jpskenn/STMeishi/README.md

# STMeishi
STM32F303CCT6 based evaluation keyboard in Meishi (= name card).

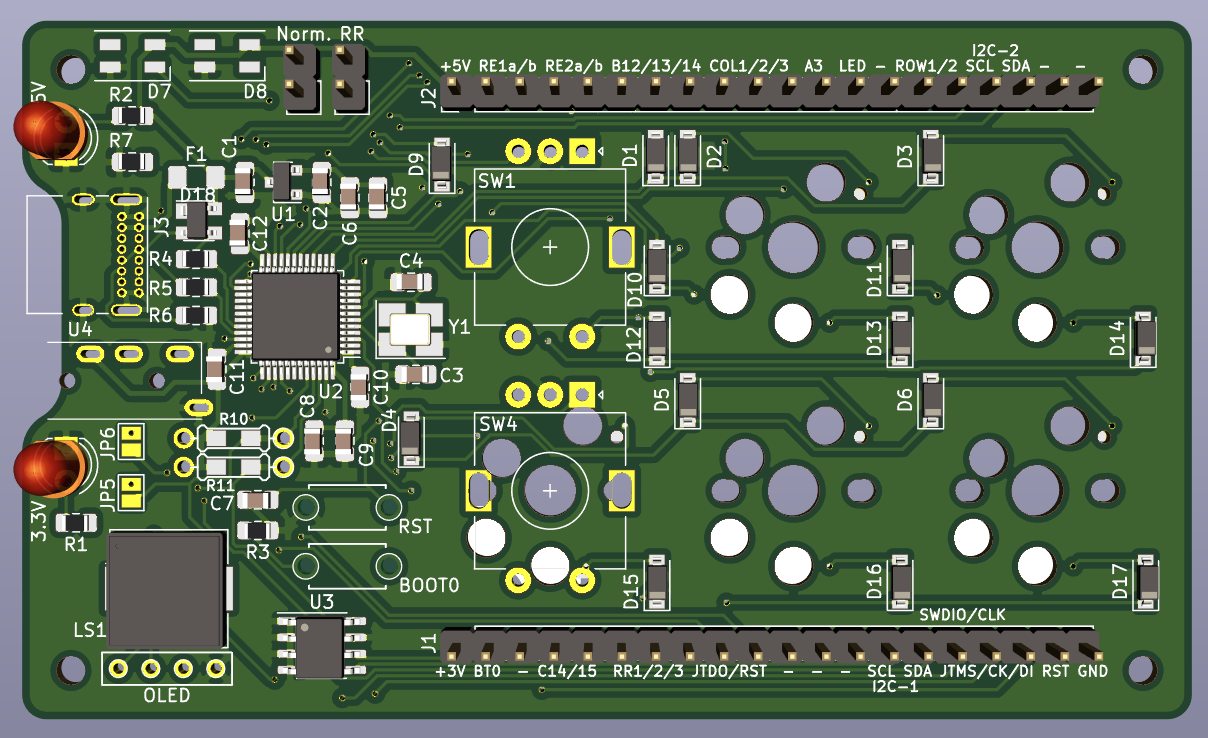
[picture p1: assets/STMeishi_v.1_3dModel_front.png]
STMeishi v.1 3D model front


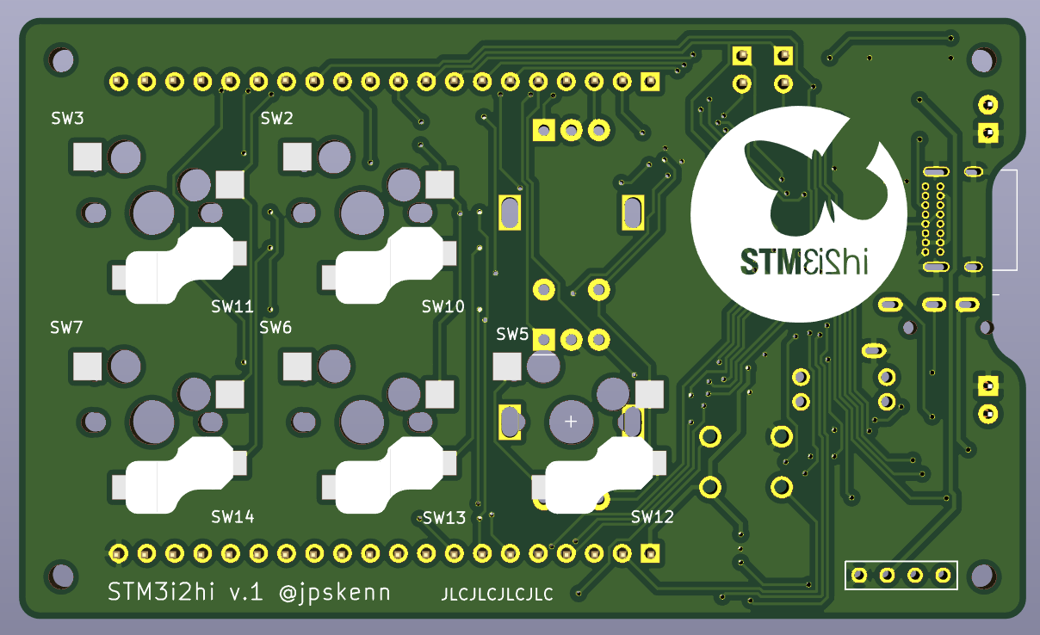
[picture p2: assets/STMeishi_v.1_3dModel_back.png]
STMeishi v.1 3D model back
