jpskenn/STMeishi/PCB/meishi_stm32.kicad_pcb

## KiCad design PCB/meishi_stm32.kicad_pcb (2020-10-25)

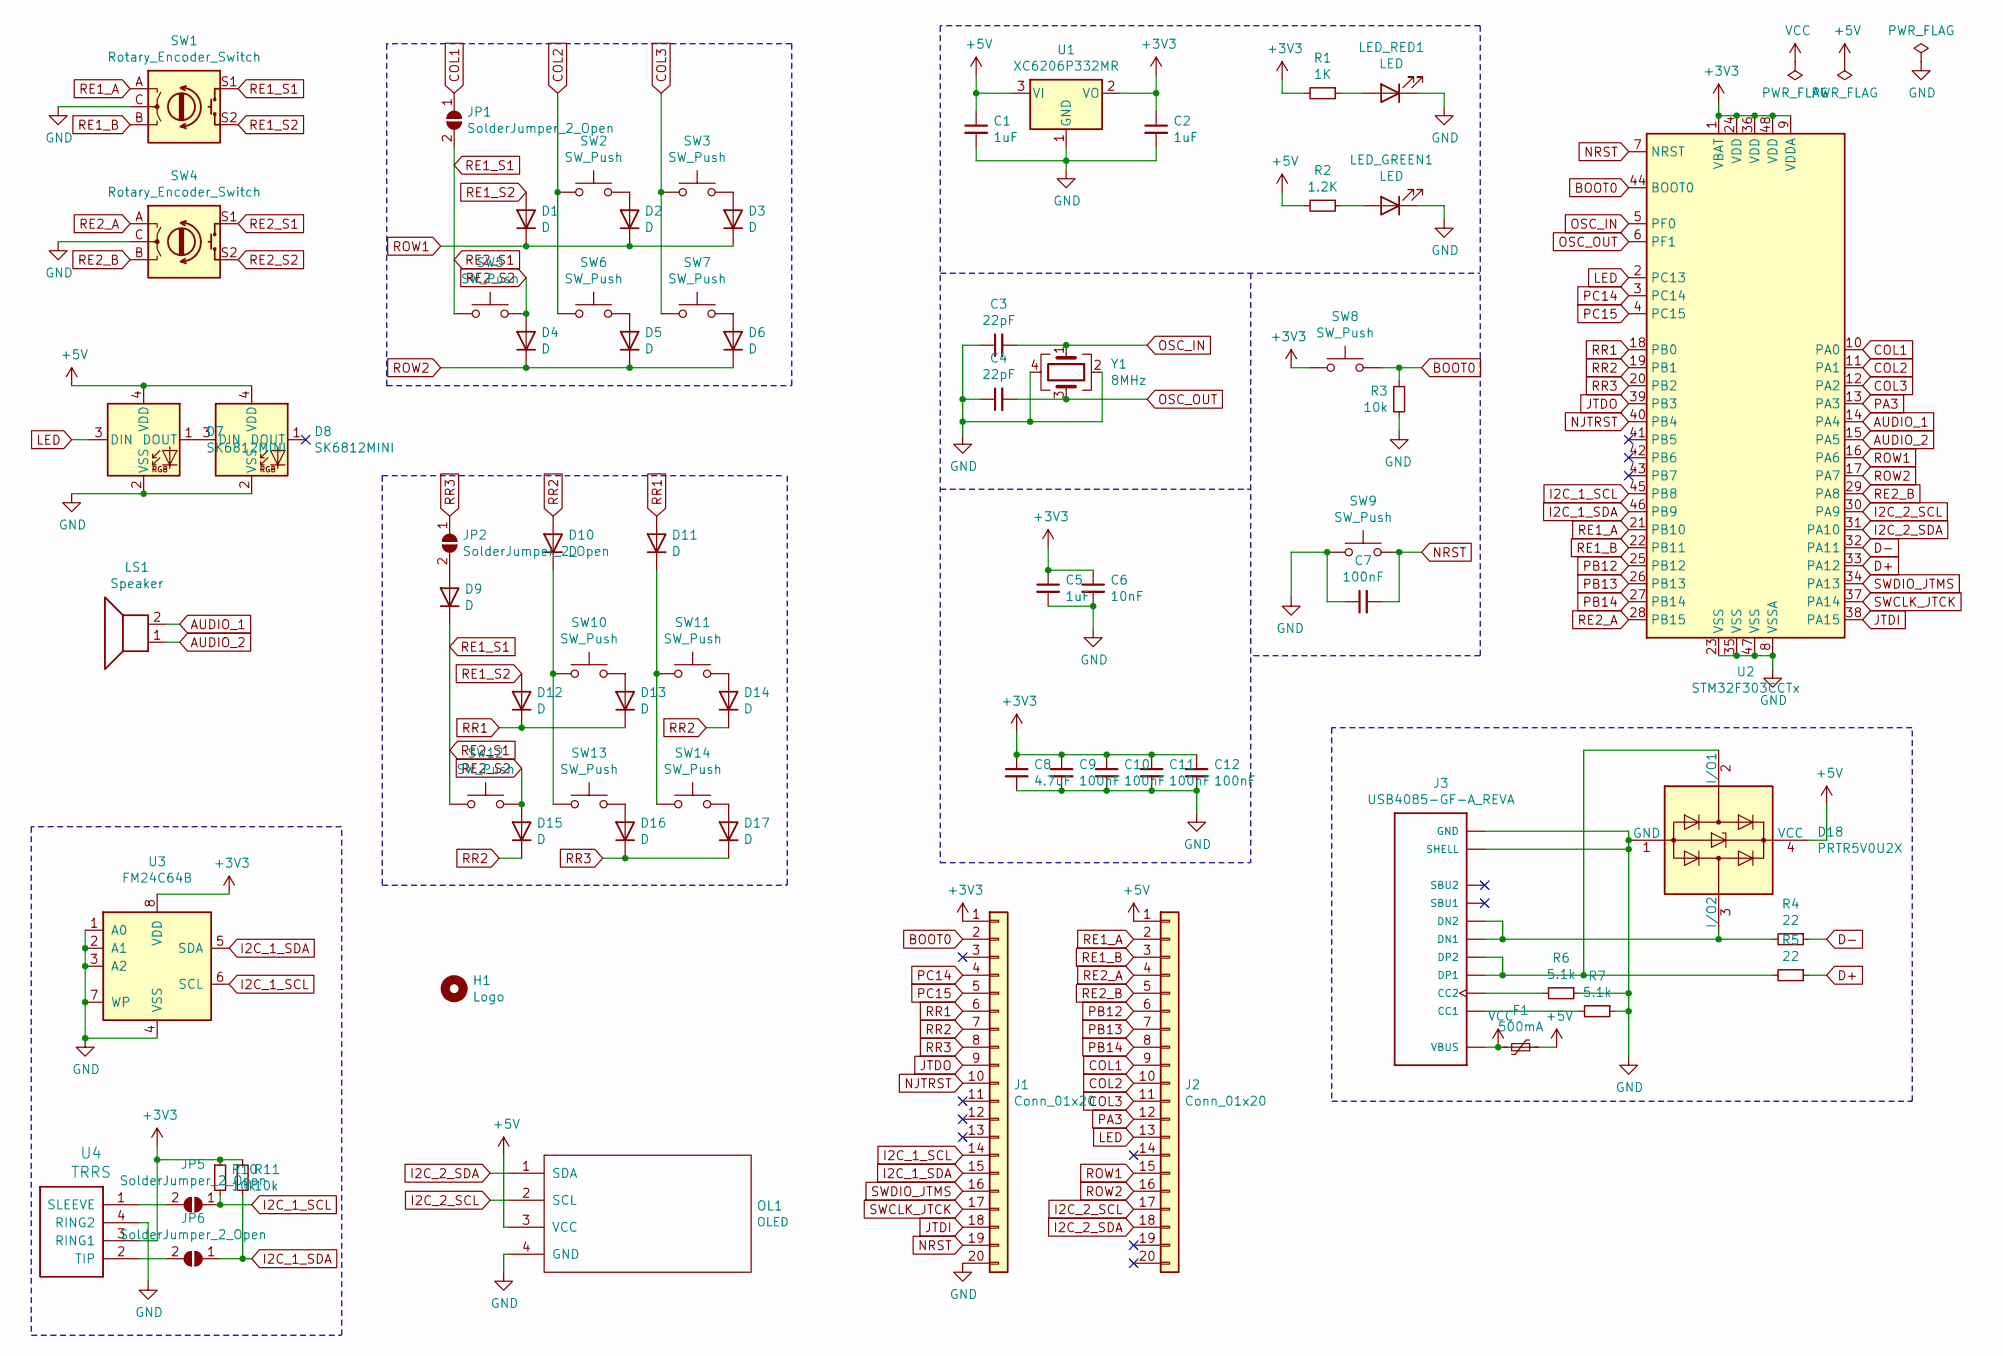
[picture p3: schematic meishi_stm32.sch]

Parts:
C1, C2, C5: 1uF; C_0805_2012Metric_Pad1.15x1.40mm_HandSolder; LCSC Part # C28323
C3, C4: 22pF; C_0805_2012Metric_Pad1.15x1.40mm_HandSolder; LCSC Part # C1804
C6: 10nF; C_0805_2012Metric_Pad1.15x1.40mm_HandSolder; LCSC Part # C15850
C7, C9, C10, C11, C12: 100nF; C_0805_2012Metric_Pad1.15x1.40mm_HandSolder; LCSC Part # C49678
C8: 4.7uF; C_0805_2012Metric_Pad1.15x1.40mm_HandSolder; LCSC Part # C1779
D1, D2, D3, D4, D5, D6, D9, D10, D11, D12, D13, D14, D15, D16, D17: D; D_SOD-123; LCSC Part # C81598
D7, D8: SK6812MINI; LED_SK6812MINI_PLCC4_3.5x3.5mm_P1.75mm
D18: PRTR5V0U2X; SOT-143; LCSC Part # C78442
F1: 500mA; Fuse_1206_3216Metric_Pad1.42x1.75mm_HandSolder; LCSC Part # C70076
H1: Logo; st_meishi_logo_475dpi
J1, J2: Conn_01x20; PinHeader_1x20_P2.54mm_Vertical
J3: USB4085-GF-A_REVA; USB_C_Receptacle_GCT_USB4085_pad_modified
JP1, JP2: SolderJumper_2_Open; PinHeader_1x02_P2.54mm_Vertical
JP5, JP6: SolderJumper_2_Open; SolderJumper-2_P1.3mm_Open_Pad1.0x1.5mm
LED_GREEN1: LED; LED_D4.0mm
LED_RED1: LED; LED_D4.0mm
LS1: Speaker; Buzzer_Murata_PKMCS0909E4000-R1
OL1: OLED
R1: 1K; R_0805_2012Metric_Pad1.15x1.40mm_HandSolder; LCSC Part # C17513
R2: 1.2K; R_0805_2012Metric_Pad1.15x1.40mm_HandSolder; LCSC Part # C17379
R3: 10k; R_0805_2012Metric_Pad1.15x1.40mm_HandSolder; LCSC Part # C17414
R4, R5: 22; R_0805_2012Metric_Pad1.15x1.40mm_HandSolder; LCSC Part # C17561
R6, R7: 5.1k; R_0805_2012Metric_Pad1.15x1.40mm_HandSolder; LCSC Part # C27834
R10, R11: 10k; Resistor-Hybrid-Front; LCSC Part # C17414
SW1, SW4: Rotary_Encoder_Switch; RotaryEncoder_Alps_EC11E-Switch_Vertical_H20mm
SW2, SW3, SW5, SW6, SW7: SW_Push; MXOnly-1U-Hotswap
SW8, SW9: SW_Push; ResetSW_1side
SW10, SW11, SW12, SW13, SW14: SW_Push; Choc_Hotswap_single_side
U1: XC6206P332MR; SOT-23; LCSC Part # C5446
U2: STM32F303CCTx; LQFP-48_7x7mm_P0.5mm; LCSC Part # C81523
U3: FM24C64B; SOIC-8_3.9x4.9mm_P1.27mm; LCSC Part # C79988
U4: TRRS; CON_MJ-4PP-9
Y1: 8MHz; Crystal_SMD_3225-4Pin_3.2x2.5mm_HandSoldering; LCSC Part # C57131

Connections:
+3V3: C2.1, C5.1, C6.1, C8.1, C9.1, C10.1, C11.1, C12.1, J1.1, R1.2, R10.1, R11.1, SW8.2, U1.2 (VO), U2.1 (VBAT), U2.9 (VDDA), U2.24 (VDD), U2.36 (VDD), U2.48 (VDD), U3.8 (VDD), U4.3 (RING1)
+5V: C1.1, D7.4 (VDD), D8.4 (VDD), D18.4 (VCC), F1.1, J2.1, OL1.3 (VCC), R2.2, U1.3 (VI)
AUDIO_1: LS1.2, U2.14 (PA4)
AUDIO_2: LS1.1, U2.15 (PA5)
BOOT0: J1.2, R3.1, SW8.1, U2.44 (BOOT0)
COL1: J2.9, JP1.1 (A), U2.10 (PA0)
COL2: J2.10, SW2.1, SW6.1, U2.11 (PA1)
COL3: J2.11, SW3.1, SW7.1, U2.12 (PA2)
D+: R5.1, U2.33 (PA12)
D-: R4.1, U2.32 (PA11)
GND: C1.2, C2.2, C3.1, C4.1, C5.2, C6.2, C7.1, C8.2, C9.2, C10.2, C11.2, C12.2, D7.2 (VSS), D8.2 (VSS), D18.1 (GND), J1.20, J3.A1 (GND), J3.A12 (GND), J3.B1 (GND), J3.B12 (GND), J3.P1 (SHELL), J3.P2 (SHELL), J3.P3 (SHELL), J3.P4 (SHELL), LED_GREEN1.1 (K), LED_RED1.1 (K), OL1.4 (GND), R3.2, R6.1, R7.1, SW1.C, SW4.C, SW9.2, U1.1 (GND), U2.8 (VSSA), U2.23 (VSS), U2.35 (VSS), U2.47 (VSS), U3.1 (A0), U3.2 (A1), U3.3 (A2), U3.4 (VSS), U3.7 (WP), U4.4 (RING2), Y1.2, Y1.4
I2C_1_SCL: J1.14, JP5.1 (A), R10.2, U2.45 (PB8), U3.6 (SCL)
I2C_1_SDA: J1.15, JP6.1 (A), R11.2, U2.46 (PB9), U3.5 (SDA)
I2C_2_SCL: J2.17, OL1.2 (SCL), U2.30 (PA9)
I2C_2_SDA: J2.18, OL1.1 (SDA), U2.31 (PA10)
JTDI: J1.18, U2.38 (PA15)
JTDO: J1.9, U2.39 (PB3)
LED: D7.3 (DIN), J2.13, U2.2 (PC13)
NJTRST: J1.10, U2.40 (PB4)
NRST: C7.2, J1.19, SW9.1, U2.7 (NRST)
unnamed: D2.2 (A), SW2.2
unnamed: D3.2 (A), SW3.2
unnamed: D5.2 (A), SW6.2
unnamed: D6.2 (A), SW7.2
unnamed: D7.1 (DOUT), D8.3 (DIN)
unnamed: D9.2 (A), JP2.2 (B)
unnamed: D10.1 (K), SW10.1, SW13.1
unnamed: D11.1 (K), SW11.1, SW14.1
unnamed: D13.2 (A), SW10.2
unnamed: D14.2 (A), SW11.2
unnamed: D16.2 (A), SW13.2
unnamed: D17.2 (A), SW14.2
unnamed: D18.2 (I/O1), J3.A6 (DP1), J3.B6 (DP2), R5.2
unnamed: D18.3 (I/O2), J3.A7 (DN1), J3.B7 (DN2), R4.2
unnamed: J3.A5 (CC1), R7.2
unnamed: J3.B5 (CC2), R6.2
unnamed: JP5.2 (B), U4.1 (SLEEVE)
unnamed: JP6.2 (B), U4.2 (TIP)
unnamed: LED_GREEN1.2 (A), R2.1
unnamed: LED_RED1.2 (A), R1.1
OSC_IN: C3.2, U2.5 (PF0), Y1.1
OSC_OUT: C4.2, U2.6 (PF1), Y1.3
PA3: J2.12, U2.13 (PA3)
PB12: J2.6, U2.25 (PB12)
PB13: J2.7, U2.26 (PB13)
PB14: J2.8, U2.27 (PB14)
PC14: J1.4, U2.3 (PC14)
PC15: J1.5, U2.4 (PC15)
RE1_A: J2.2, SW1.A, U2.21 (PB10)
RE1_B: J2.3, SW1.B, U2.22 (PB11)
RE1_S1: D9.1 (K), JP1.2 (B), SW1.S1, SW4.S1, SW5.1, SW12.1
RE1_S2: D1.2 (A), D12.2 (A), SW1.S2
RE2_A: J2.4, SW4.A, U2.28 (PB15)
RE2_B: J2.5, SW4.B, U2.29 (PA8)
RE2_S2: D4.2 (A), D15.2 (A), SW4.S2, SW5.2, SW12.2
ROW1: D1.1 (K), D2.1 (K), D3.1 (K), J2.15, U2.16 (PA6)
ROW2: D4.1 (K), D5.1 (K), D6.1 (K), J2.16, U2.17 (PA7)
RR1: D11.2 (A), D12.1 (K), D13.1 (K), J1.6, U2.18 (PB0)
RR2: D10.2 (A), D14.1 (K), D15.1 (K), J1.7, U2.19 (PB1)
RR3: D16.1 (K), D17.1 (K), J1.8, JP2.1 (A), U2.20 (PB2)
SWCLK_JTCK: J1.17, U2.37 (PA14)
SWDIO_JTMS: J1.16, U2.34 (PA13)
VCC: F1.2, J3.A4 (VBUS), J3.A9 (VBUS), J3.B4 (VBUS), J3.B9 (VBUS)

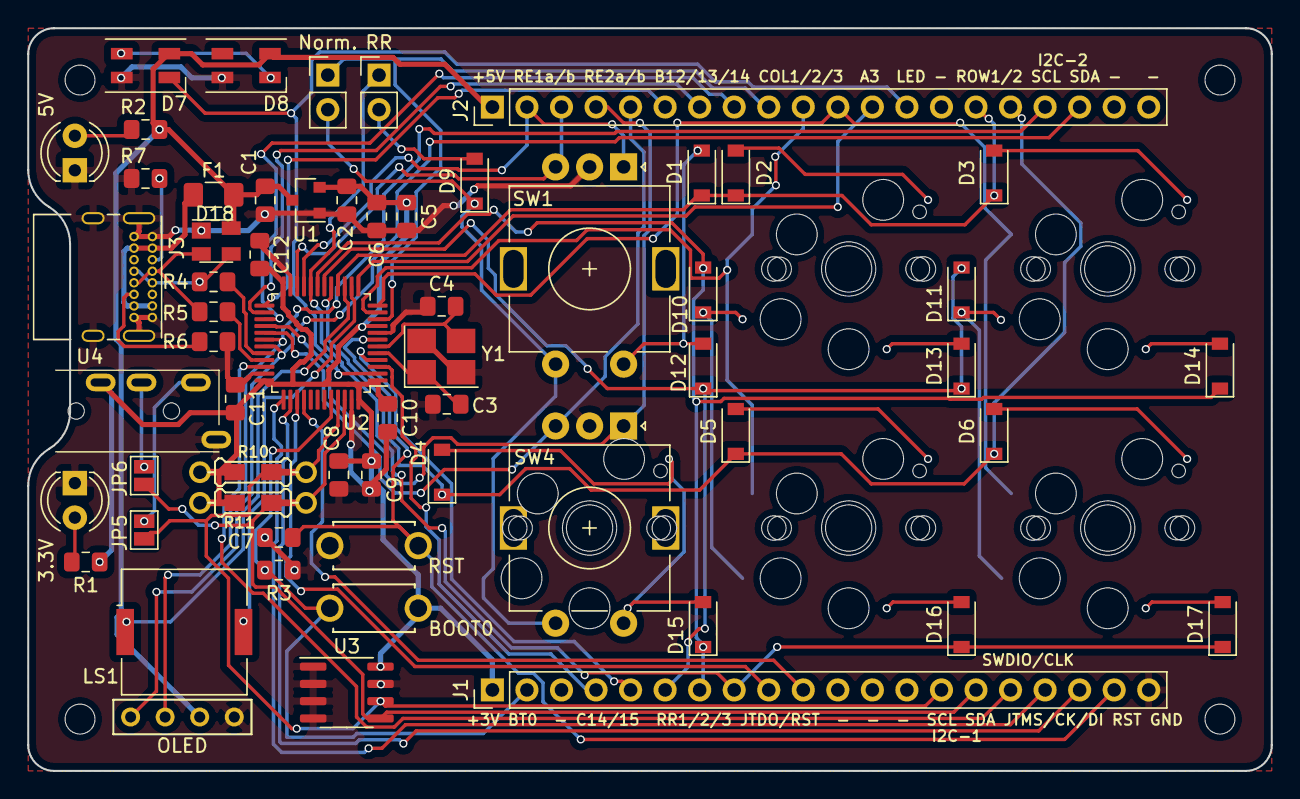
[picture p4: board meishi_stm32.kicad_pcb from above]

Board: 2 copper layers, 91.4 x 54.6 mm, 71 parts (1 on the bottom side), 63 nets.
